Archie3d/stochastic_fpga_synth/hdl/MIDI_Note2Freq.vhd

--------------------------------------------------------------------------------
-- MIDI_Note2Freq
--------------------------------------------------------------------------------
-- Translace MIDI note number to frequency assuming 100MHz master clock
-- and 16-bit integrator.
-- This unit produces three slightly detuned frequenced.
-- Freq0 is always in tune.
--------------------------------------------------------------------------------

library ieee;
use ieee.std_logic_1164.all;
use ieee.numeric_std.all;


entity MIDI_Note2Freq is
    port(
        Clk   : in std_logic;
        Note  : in std_logic_vector(6 downto 0);
        Busy  : in std_logic;
        
        Freq0 : out std_logic_vector(15 downto 0);
        Freq1 : out std_logic_vector(15 downto 0);
        Freq2 : out std_logic_vector(15 downto 0)
	);
end entity;


architecture Behavioral of MIDI_Note2Freq is

    signal r_Freq0 : unsigned(15 downto 0) := (others => '0');
    signal r_Freq1 : unsigned(15 downto 0) := (others => '0');
    signal r_Freq2 : unsigned(15 downto 0) := (others => '0');
		
begin
    process (Clk)
        variable note_number : integer;
    begin
        if rising_edge(Clk) then
        
            -- Update the output only when the voice is not busy
            if Busy = '0' then
                note_number := to_integer(unsigned(Note));
            
                case note_number is
                    when 12 =>
                        r_Freq0 <= to_unsigned(702, 16);
                        r_Freq1 <= to_unsigned(705, 16);
                        r_Freq2 <= to_unsigned(705, 16);
                    when 13 =>
                        r_Freq0 <= to_unsigned(744, 16);
                        r_Freq1 <= to_unsigned(741, 16);
                        r_Freq2 <= to_unsigned(741, 16);
                    when 14 =>
                        r_Freq0 <= to_unsigned(788, 16);
                        r_Freq1 <= to_unsigned(792, 16);
                        r_Freq2 <= to_unsigned(784, 16);
                    when 15 =>
                        r_Freq0 <= to_unsigned(835, 16);
                        r_Freq1 <= to_unsigned(838, 16);
                        r_Freq2 <= to_unsigned(832, 16);
                    when 16 =>
                        r_Freq0 <= to_unsigned(885, 16);
                        r_Freq1 <= to_unsigned(881, 16);
                        r_Freq2 <= to_unsigned(882, 16);
                    when 17 =>
                        r_Freq0 <= to_unsigned(937, 16);
                        r_Freq1 <= to_unsigned(942, 16);
                        r_Freq2 <= to_unsigned(941, 16);
                    when 18 =>
                        r_Freq0 <= to_unsigned(993, 16);
                        r_Freq1 <= to_unsigned(990, 16);
                        r_Freq2 <= to_unsigned(992, 16);
                    when 19 =>
                        r_Freq0 <= to_unsigned(1052, 16);
                        r_Freq1 <= to_unsigned(1056, 16);
                        r_Freq2 <= to_unsigned(1055, 16);
                    when 20 =>
                        r_Freq0 <= to_unsigned(1115, 16);
                        r_Freq1 <= to_unsigned(1110, 16);
                        r_Freq2 <= to_unsigned(1109, 16);
                    when 21 =>
                        r_Freq0 <= to_unsigned(1181, 16);
                        r_Freq1 <= to_unsigned(1187, 16);
                        r_Freq2 <= to_unsigned(1186, 16);
                    when 22 =>
                        r_Freq0 <= to_unsigned(1251, 16);
                        r_Freq1 <= to_unsigned(1255, 16);
                        r_Freq2 <= to_unsigned(1248, 16);
                    when 23 =>
                        r_Freq0 <= to_unsigned(1326, 16);
                        r_Freq1 <= to_unsigned(1330, 16);
                        r_Freq2 <= to_unsigned(1331, 16);
                    when 24 =>
                        r_Freq0 <= to_unsigned(1405, 16);
                        r_Freq1 <= to_unsigned(1402, 16);
                        r_Freq2 <= to_unsigned(1402, 16);
                    when 25 =>
                        r_Freq0 <= to_unsigned(1488, 16);
                        r_Freq1 <= to_unsigned(1481, 16);
                        r_Freq2 <= to_unsigned(1491, 16);
                    when 26 =>
                        r_Freq0 <= to_unsigned(1577, 16);
                        r_Freq1 <= to_unsigned(1576, 16);
                        r_Freq2 <= to_unsigned(1572, 16);
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
                        r_Freq2 <= to_unsigned(60138, 16);
                    when 90 =>
                        r_Freq0 <= to_unsigned(63565, 16);
                        r_Freq1 <= to_unsigned(63830, 16);
                        r_Freq2 <= to_unsigned(63361, 16);


                    when others =>
                        r_Freq0 <= to_unsigned(0, 16);
                        r_Freq1 <= to_unsigned(0, 16);
                        r_Freq2 <= to_unsigned(0, 16);

                end case;

                
            end if; -- Busy = '0'
            
        end if;

    end process;

    Freq0 <= std_logic_vector(r_Freq0);
    Freq1 <= std_logic_vector(r_Freq1);
    Freq2 <= std_logic_vector(r_Freq2);
    
end Behavioral;
